mm13000/sunrise-alarm/README.md

The [Context and Decisions](./docs/implementation_notes.md) document provides a detailed overview of design decisions made and implementation details. The primary purpose is to be an up-to-date source of truth that I can give to an AI model (I've been using Gemini) so that I don't have to repeat myself or explain decisions whenever I start a new chat.
