mm13000/sunrise-alarm/(commit log)

2026-01-11 Outline of state and button functionality. A few other changes.
2026-01-16 fix bug preventing alarm from being turned off
    [sunrise-alarm.ino]
2026-11-12 Add MOSFET datasheet
2026-11-12 add EasyEDA PCB files and updated .gitignore
2026-11-12 minor addition to implemenation notes: hand soldering so need through-hole components
2026-11-13 Update implementation notes: add details of arduino pins
